elcano/Sweep/README.md

# Sweep
Lidar data collection from Scanse Sweep
