elcano/Sweep/Electronics/BOM for Scanse Sweep.xlsx

Index | Quantity | Part Number | Manufacturer Part Number | Description | Link | Available | Backorder | Unit Price | Total Price
1 | 1 | 945-1395-5-ND | R-78C5.0-1.0 | DC DC CONVERTER 5V 5W | https://www.digikey.com/product-detail/en/R-78C5.0-1.0/945-1395-5-ND/2652148/?itemSeq=306523351 | 1 | 0 | 8.81 | 8.81
2 | 7 | 493-10420-1-ND | UMA1H0R1MCD2TP | CAP ALUM 0.1UF 20% 50V RADIAL | https://www.digikey.com/product-detail/en/UMA1H0R1MCD2TP/493-10420-1-ND/4312679/?itemSeq=306523996 | 7 | 0 | 0.28 | 1.96
3 | 1 | XC1759-ND | ECS-160-20-46X | CRYSTAL 16.0000MHZ 20PF T/H | https://www.digikey.com/product-detail/en/ECS-160-20-46X/XC1759-ND/2676589/?itemSeq=306524128 | 1 | 0 | 0.39 | 0.39
4 | 1 | MCP2551T-I/P-ND | MCP2551T-I/P | IC TRANSCEIVER HALF 1/1 8DIP | https://www.digikey.com/product-detail/en/MCP2551-I%2fP/MCP2551-I%2fP-ND/509453/?itemSeq=307298138 | 1 | 0 | 1.12 | 1.12
5 | 7 | 952-2262-ND | M20-9990246 | CONN HEADER VERT 2POS 2.54MM | https://www.digikey.com/product-detail/en/M20-9990246/952-2262-ND/3728226/?itemSeq=306525033 | 7 | 0 | 0.11 | 0.77
6 | 1 | MCP2515-I/P-ND | MCP2515-I/P | IC CAN CONTROLLER W/SPI 18DIP | https://www.digikey.com/product-detail/en/MCP2515-I%2fP/MCP2515-I%2fP-ND/593000/?itemSeq=306541792 | 1 | 0 | 1.87 | 1.87
7 | 1 | 1528-1074-ND | 85 | STACKING HEADER ARDUINO SHIELD | https://www.digikey.com/product-detail/en/85/1528-1074-ND/5154649/?itemSeq=306858030 | 1 | 0 | 1.95 | 1.95
8 | 1 | WM7860-ND | 0393570004 | TERM BLK 4POS SIDE ENT 3.5MM PCB | https://www.digikey.com/product-detail/en/0393570004/WM7860-ND/1280711/?itemSeq=307038578 | 1 | 0 | 1.60 | 1.60
9 | 1 | 455-1673-ND | S6B-ZR(LF)(SN) | CONN HEADER R/A 6POS 1.5MM | https://www.digikey.com/product-detail/en/S6B-ZR(LF)(SN)/455-1673-ND/926580/?itemSeq=307041578 | 1 | 0 | 0.32 | 0.32
10 | 1 | CF14JT120RTC-ND | CF14JT120R | 120 Ohm Resistor | https://www.digikey.com/product-detail/en/CF14JT120R/CF14JT120RCT-ND/1830329/?itemSeq=308128550 | 1 | 0 | 0.10 | 0.10
11 | 1 | PPC1.0KBCT-ND | NFR25H0001001JR500 | 1k Ohm Resistor | https://www.digikey.com/product-detail/en/vishay-bc-components/NFR25H0001001JR500/PPC1.0KBCT-ND/614242 | 1 | 0 | 0.44 | 0.44
12 |  |  |  | 10k Ohm Resistor
13 | 1 | RNF18FTD20K0CT-ND | RNF18FTD20K0 | 20k Ohm Resistor | https://www.digikey.com/product-detail/en/stackpole-electronics-inc/RNF18FTD20K0/RNF18FTD20K0CT-ND/2022671 | 1 | 0 | 0.10 | 0.10
 |  |  |  |  |  |  |  | Total | 19.43
