elcano/Sweep/Electronics/ScanseSweep Final.brd

## EAGLE design Electronics/ScanseSweep Final.brd (2019-12-10)

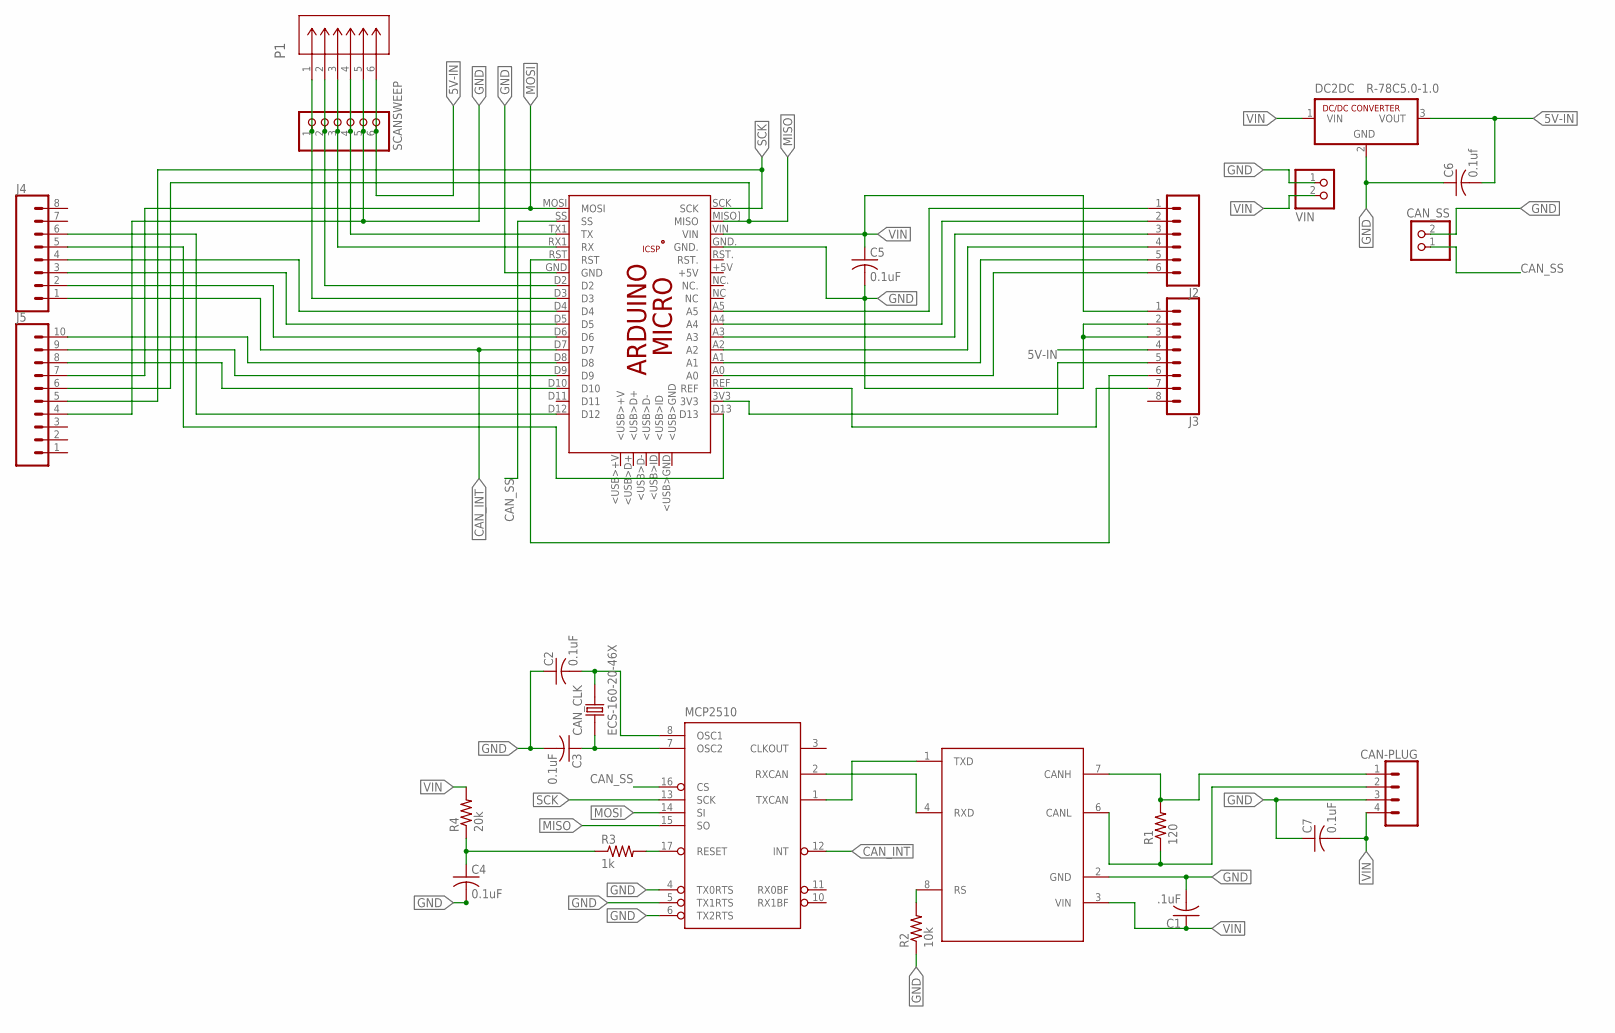
[picture p1: schematic ScanseSweep Final.sch]

Parts:
C1: .1uF; C025-024X044
C2, C3, C4, C5, C7: 0.1uF; C025-024X044
C6: 0.1uf; C025-024X044
CAN_CLK: ECS-160-20-46X; XTAL_ECS-160-20-46X
CAN_SS_TEST: CAN_SS; 1X02
DC2DC: R-78C5.0-1.0; SIP3
J1: CAN-PLUG; SCREWTERMINAL-3.5MM-4
J2: CONN_06SILK_FEMALE_PTH; 1X06
J3, J4: CONN_08"; 1X08
J5: CONN_10"; 1X10
MCP2510: MCP2510P; DIL18
MCP2551: MCP2551MCP2551; DIL08
P1: S6B-ZR(LF)(SN); S6B-ZR
PCB2: ARDUINO_MICRO
R1: 120; 0204/5
R2: 10k; 0204/5
R3: 1k; 0204/5
R4: 20k; 0204/5
SCANSESWEEP: SCANSWEEP; 1X06
VIN_TEST: VIN; 1X02

Connections:
3.3V: J3.5, PCB2.3V3
5V-IN: C6.2, DC2DC.3 (VOUT), J3.4, P1.6, SCANSESWEEP.6
A0: J2.6, PCB2.A0
A1: J2.5, PCB2.A1
A2: J2.4, PCB2.A2
A3: J2.3, PCB2.A3
A4: J2.2, PCB2.A4
A5: J2.1, PCB2.A5
CANH: J1.1, MCP2551.7 (CANH), R1.2
CANL: J1.2, MCP2551.6 (CANL), R1.1
CAN_INT: J4.1, MCP2510.12 (INT), PCB2.D7
CAN_SS: CAN_SS_TEST.1, MCP2510.16 (CS), PCB2.SS
D2: P1.2, PCB2.D2, SCANSESWEEP.2
D3: P1.1, PCB2.D3, SCANSESWEEP.1
D4: J4.4, PCB2.D4
D5: J4.3, PCB2.D5
D6: J4.2, PCB2.D6
D8: J5.10, PCB2.D8
D9: J5.9, PCB2.D9
D10: J5.8, PCB2.D10
D12: J4.6, PCB2.D12
D13: J4.5, PCB2.D13
GND: C1.2, C2.1, C3.2, C4.2, C5.2, C6.1, C7.1, CAN_SS_TEST.2, DC2DC.2 (GND), J1.3, J3.2, J3.3, J5.4, MCP2510.4 (TX0RTS), MCP2510.5 (TX1RTS), MCP2510.6 (TX2RTS), MCP2551.2 (GND), P1.5, PCB2.GND, PCB2.GND., R2.1, SCANSESWEEP.5, VIN_TEST.1
MISO: J5.6, MCP2510.15 (SO), PCB2.MISO] (MISO)
MOSI: J5.7, MCP2510.14 (SI), PCB2.MOSI
unnamed: C4.1, R3.1, R4.1
OSC1: C2.2, CAN_CLK.2, MCP2510.8 (OSC1)
OSC2: C3.1, CAN_CLK.1, MCP2510.7 (OSC2)
REF: J3.7, PCB2.REF
RESET: MCP2510.17 (RESET), R3.2
RS: MCP2551.8 (RS), R2.2
RST: J3.6, PCB2.RST
RX: P1.3, PCB2.RX1 (RX), SCANSESWEEP.3
RXCAN: MCP2510.2 (RXCAN), MCP2551.4 (RXD)
SCK: J5.5, MCP2510.13 (SCK), PCB2.SCK
TX: P1.4, PCB2.TX1 (TX), SCANSESWEEP.4
TXCAN: MCP2510.1 (TXCAN), MCP2551.1 (TXD)
VIN: C1.1, C5.1, C7.2, DC2DC.1 (VIN), J1.4, J3.1, MCP2551.3 (VIN), PCB2.VIN, R4.2, VIN_TEST.2

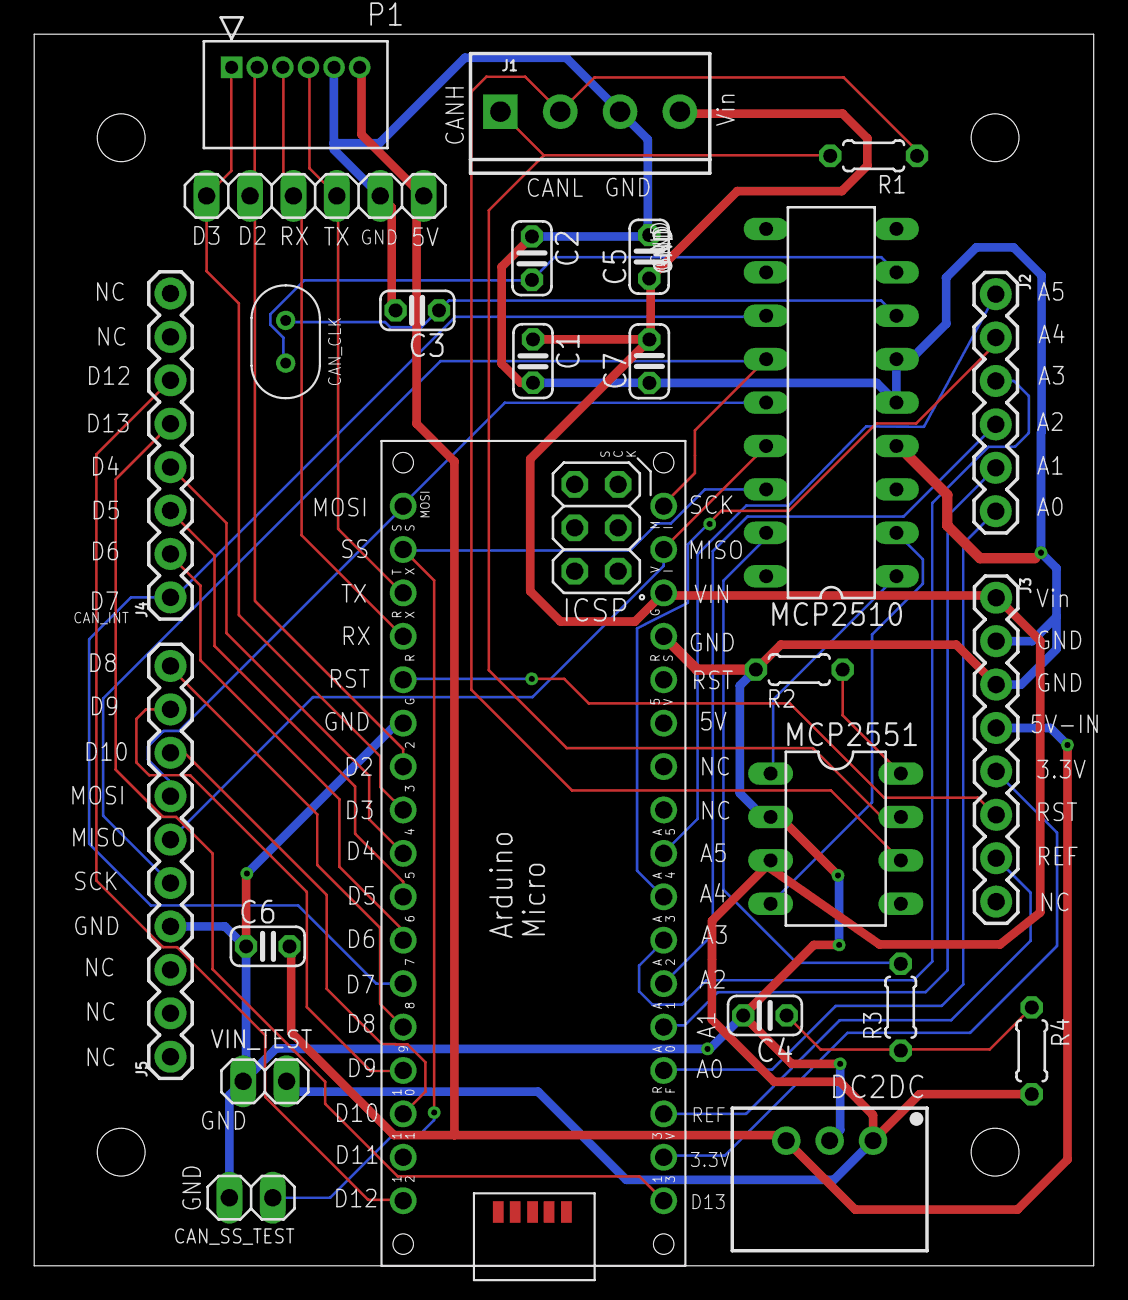
[picture p2: board ScanseSweep Final.brd from above]

Board: 2 copper layers, 62.0 x 72.1 mm, 25 parts (0 on the bottom side), 38 nets.
