elcano/Sweep/(commit log)

2019-12-10 Mitchell Dean's Sweep Code
    [BOM for Scanse Sweep.xlsx, ScanseSweep Final.brd, ScanseSweep Final.sch]
2019-12-10 Files for CAN bus
    CAN files should eventually be moved to Elcano/General.
    Sweep code needs to be modified to call the CAN routines.
2019-12-10 Modifications needed to PCB
    Basis for building the next version
